FrederickAmpsUp/osmium/notes.md

# `osmium` Developer's Notes

## Connectors
- Deutsch DT06-4S connectors will be used for the node bus cabling
- Deutsch DT13-4P for the nodes themselves

## Electronics
- All nodes will use the ESP32-S3-WROOM-1 MCU
- THVD1410D RS-485 transciever chips
- LMR16006 voltage regulator
