FrederickAmpsUp/osmium/kicad-parts/DT13-4P/DT13-4P.step

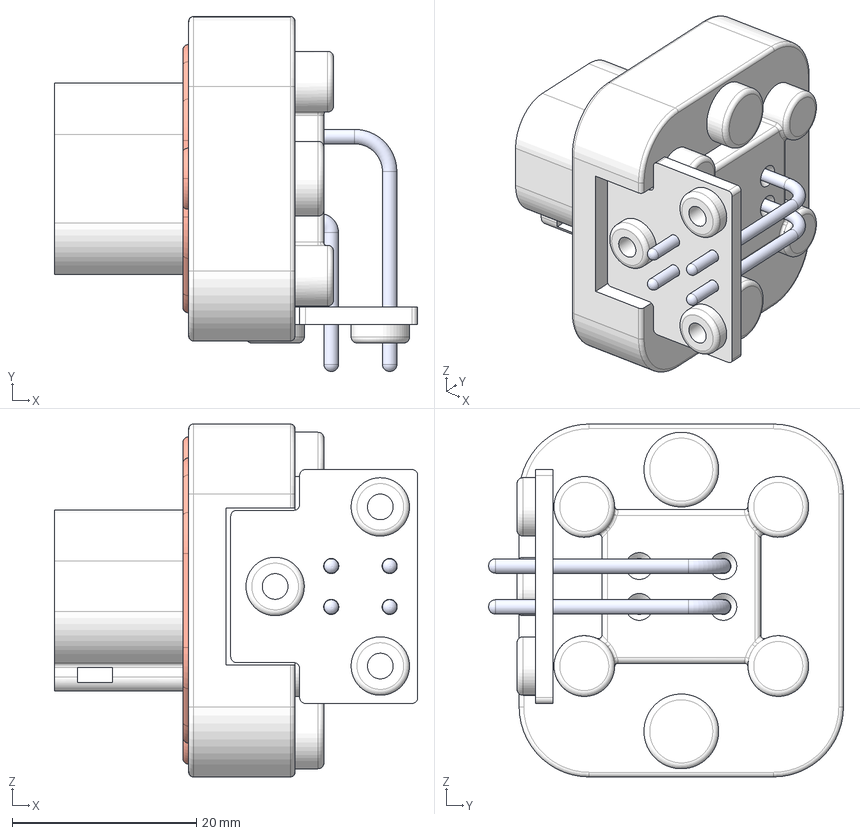
[picture p1: CAD file, 2026-06-23]
kicad-parts/DT13-4P/DT13-4P.step
39.5 x 38.6 x 38.4 mm
