FrederickAmpsUp/osmium/kicad-parts/USB4120-03-C_REVA6/USB4120-03-C_REVA6.step

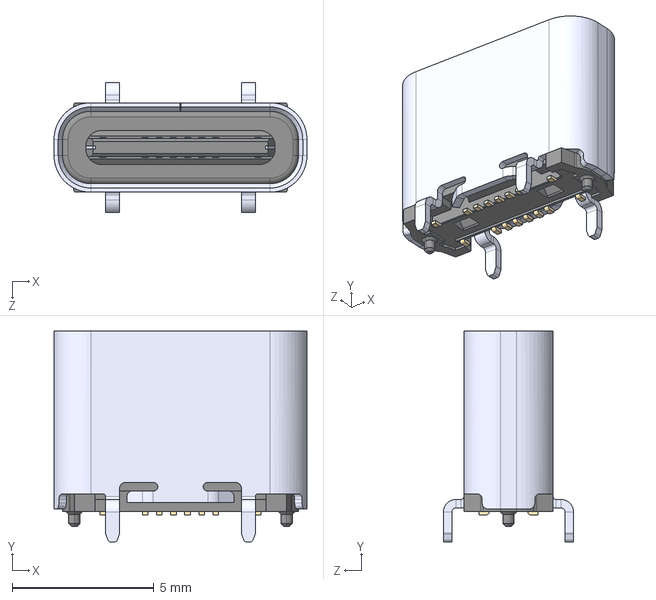
[picture p2: CAD file, 2026-06-23]
kicad-parts/USB4120-03-C_REVA6/USB4120-03-C_REVA6.step
8.94 x 7.45 x 4.60 mm
