FrederickAmpsUp/osmium/osmium-node-1/cad/OsmiumNode1CaseBottom.step

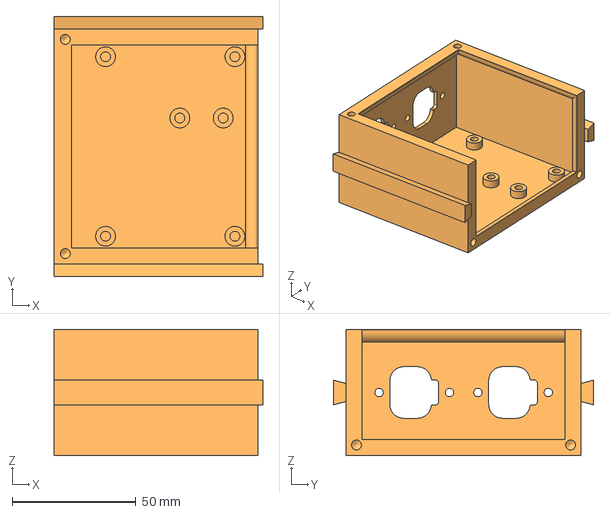
[picture p3: CAD file, 2026-08-07]
osmium-node-1/cad/OsmiumNode1CaseBottom.step
84.2 x 105.0 x 50.9 mm
