FrederickAmpsUp/osmium/osmium-node-1/cad/OsmiumNode1CaseTop.step

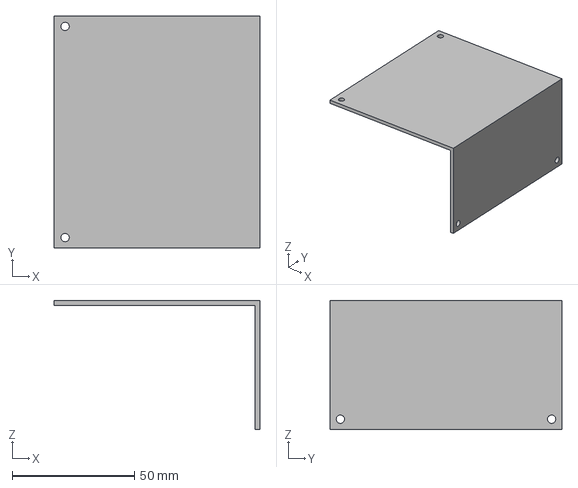
[picture p4: CAD file, 2026-08-07]
osmium-node-1/cad/OsmiumNode1CaseTop.step
84.2 x 95.0 x 52.9 mm
