FrederickAmpsUp/osmium/osmium-node-1/osmium-node-1.kicad_pcb

## KiCad design osmium-node-1/osmium-node-1.kicad_pcb (2026-07-16)

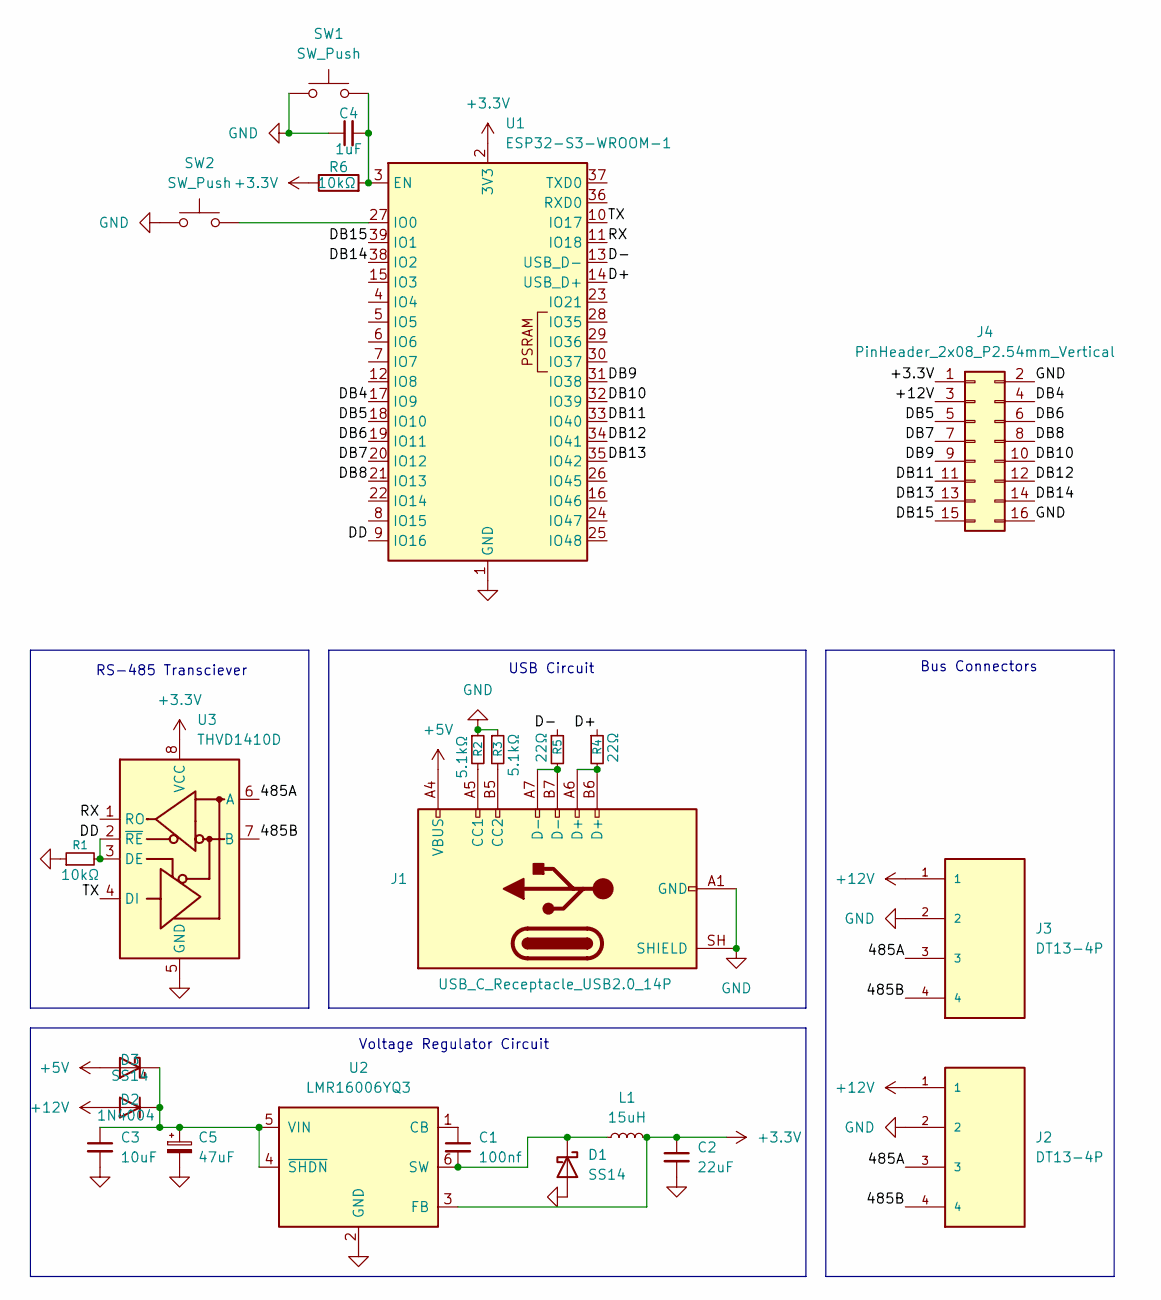
[picture p5: schematic osmium-node-1.kicad_sch, osmium Node v1]

Parts:
C1: 100nf; C_0805_2012Metric
C2: 22uF; C_1206_3216Metric
C3: 10uF; C_1206_3216Metric
C4: 1uF; C_0805_2012Metric
C5: 47uF; CP_Elec_6.3x5.4
D1, D3: SS14; D_SMA
D2: 1N4004; D_DO-41_SOD81_P10.16mm_Horizontal
J1: USB_C_Receptacle_USB2.0_14P; GCT_USB4120-03-C_REVA6
J2, J3: DT13-4P; TE_DT13-4P; PARTREV C1
J4: PinHeader_2x08_P2.54mm_Vertical
L1: 15uH; L_7.3x7.3_H4.5
R1, R6: 10kΩ; R_0805_2012Metric
R2, R3: 5.1kΩ; R_0805_2012Metric
R4, R5: 22Ω; R_0805_2012Metric
SW1, SW2: SW_Push; SW_PUSH_6mm
U1: ESP32-S3-WROOM-1
U2: LMR16006YQ3; SOT-23-6
U3: THVD1410D; SOIC-8_3.9x4.9mm_P1.27mm

Connections:
+3.3V: C2.1, J4.1, L1.2, R6.1, U1.2 (3V3), U2.3 (FB), U3.8 (VCC)
+5V: D3.2 (A), J1.A4 (VBUS), J1.A9 (VBUS), J1.B4 (VBUS), J1.B9 (VBUS)
+12V: D2.2 (A), J2.1, J3.1, J4.3
/485A: J2.3, J3.3, U3.6 (A)
/485B: J2.4, J3.4, U3.7 (B)
/D+: R4.1, U1.14 (USB_D+)
/D-: R5.1, U1.13 (USB_D-)
/DB4: J4.4, U1.17 (IO9)
/DB5: J4.5, U1.18 (IO10)
/DB6: J4.6, U1.19 (IO11)
/DB7: J4.7, U1.20 (IO12)
/DB8: J4.8, U1.21 (IO13)
/DB9: J4.9, U1.31 (IO38)
/DB10: J4.10, U1.32 (IO39)
/DB11: J4.11, U1.33 (IO40)
/DB12: J4.12, U1.34 (IO41)
/DB13: J4.13, U1.35 (IO42)
/DB14: J4.14, U1.38 (IO2)
/DB15: J4.15, U1.39 (IO1)
/DD: R1.2, U1.9 (IO16), U3.2 (~RE), U3.3 (DE)
/RX: U1.11 (IO18), U3.1 (RO)
/TX: U1.10 (IO17), U3.4 (DI)
GND: C2.2, C3.2, C4.1, C5.2, D1.2 (A), J1.A1 (GND), J1.A12 (GND), J1.B1 (GND), J1.B12 (GND), J1.S1, J1.S2, J1.S3, J1.S4, J1.SH (SHIELD), J2.2, J3.2, J4.2, J4.16, R1.1, R2.1, R3.1, SW1.1, SW2.1, U1.1 (GND), U1.40 (GND), U1.41 (GND), U2.2 (GND), U3.5 (GND)
unnamed: C1.2, D1.1 (K), L1.1, U2.6 (SW)
unnamed: C3.1, C5.1, D2.1 (K), D3.1 (K), U2.4 (~SHDN), U2.5 (VIN)
unnamed: J1.A5 (CC1), R2.2
unnamed: J1.B5 (CC2), R3.2
unnamed: J1.A6 (D+), J1.B6 (D+), R4.2
unnamed: J1.A7 (D-), J1.B7 (D-), R5.2
unnamed: C4.2, R6.2, SW1.2, U1.3 (EN)
unnamed: SW2.2, U1.27 (IO0)
unnamed: C1.1, U2.1 (CB)

Notes on the sheet:
Bus Connectors
RS-485 Transciever
USB Circuit
Voltage Regulator Circuit

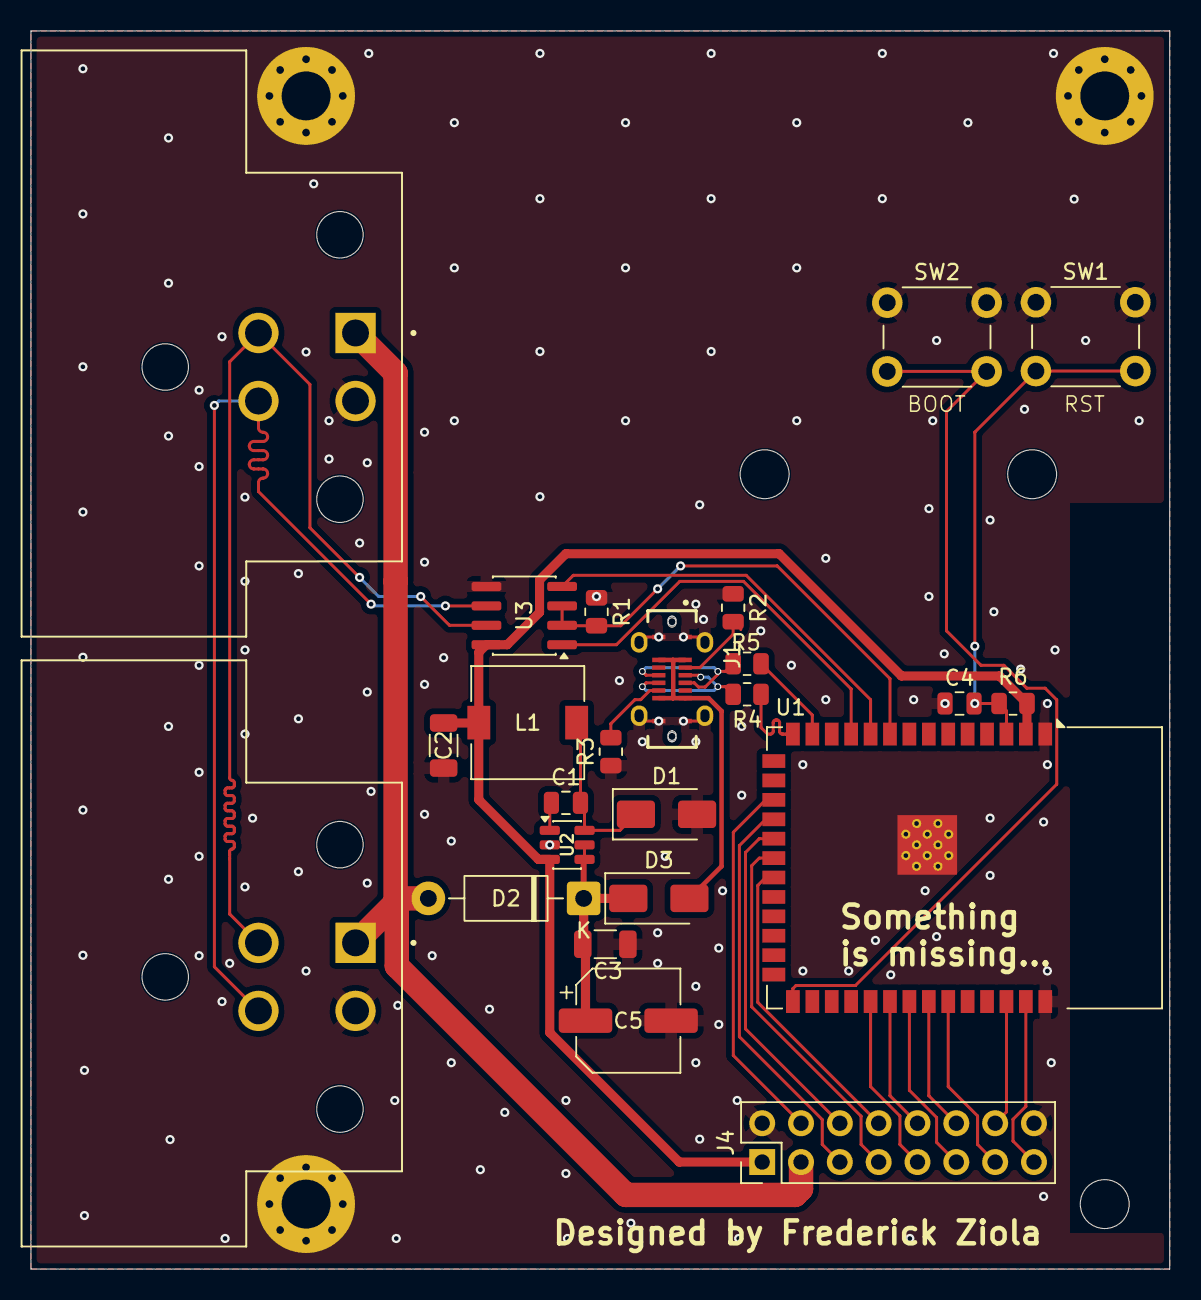
[picture p6: board osmium-node-1.kicad_pcb from above]

Board: 2 copper layers, 74.5 x 81.0 mm, 24 parts (0 on the bottom side), 32 nets.
