FrederickAmpsUp/osmium/firmware/src/drivers/nodebus_sender.cpp

#include "drivers/nodebus_sender.hpp"
#include "drivers/nodebus.hpp"

namespace osmium {

NodebusSender::NodebusSender(uint8_t id) : id(id) {
}

static inline void send_byte(uint16_t &crc, Stream &stream, uint8_t byte) {
  crc = update_crc16(crc, byte);
  stream.write(byte);
}

void NodebusSender::send(Stream &stream, uint8_t target_id, const uint8_t *payload, size_t payload_size) {
  uint16_t crc = NODEBUS_CRC_INIT;

  // send SOF
  stream.write(NODEBUS_SOF, NODEBUS_SOF_SIZE);

  // send version
  send_byte(crc, stream, NODEBUS_PACKET_VERSION_V1);

  // send target
  send_byte(crc, stream, target_id);

  // send source
  send_byte(crc, stream, this->id);

  // copy because we need payload_size later
  uint16_t packet_payload_size = payload_size;
  do {
    // bottom 7 bits
    uint8_t byte = packet_payload_size & 0x7F;
    packet_payload_size >>= 7;

    // another byte will follow
    if (packet_payload_size > 0) {
      byte |= 0x80;
    }

    send_byte(crc, stream, byte);
  } while (packet_payload_size > 0);

  // send the payload
  for (int i = 0; i < payload_size; ++i) {
    send_byte(crc, stream, payload[i]);
  }

  // send computed CRC
  stream.write((uint8_t)(crc >> 8));
  stream.write((uint8_t)(crc & 0xFF));
}

}
