FrederickAmpsUp/osmium/(commit log)

2026-06-24 Add gitignore in PCB folder
2026-07-16 Update PCB
    [osmium-node-1.kicad_pcb]
2026-08-01 Add basic moisture sensor driver
2026-08-07 Add case files
    [OsmiumNode1CaseBottom.step, OsmiumNode1CaseTop.step]
2026-08-07 Add prototype firmware harnesses
